Prelo3D/graber-p3d/Fotos do projeto/20.PNG

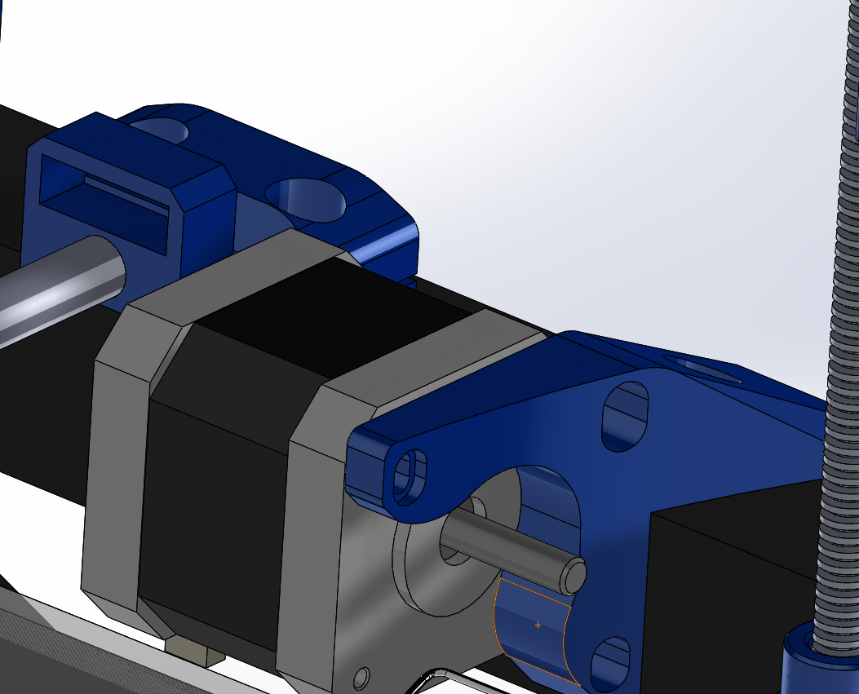
Fotos do projeto/20.PNG
