Prelo3D/graber-p3d/Fotos do projeto/16.PNG

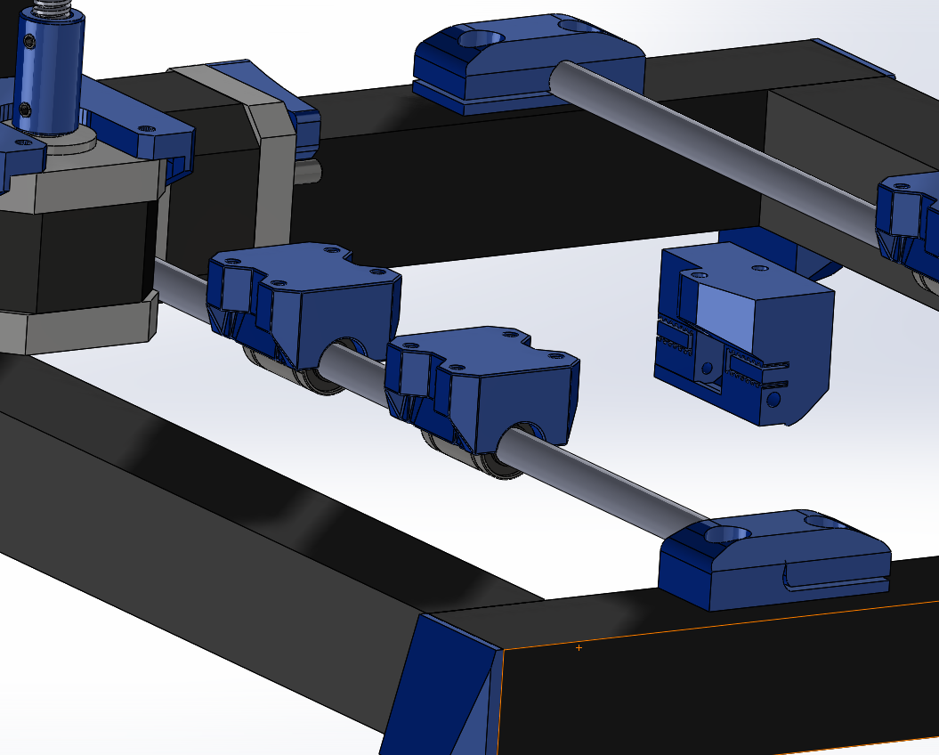
Fotos do projeto/16.PNG
