Prelo3D/graber-p3d/README.md

# **Graber-p3d**
Aqui você encontra o projeto da impressora graber-p3d com área de impressão de 220x220x220.
O projeto já está pronto, mas ainda falta terminar o upload de alguns arquivos aqui. Nosso foco é a mecânica da máquina, então, além de encontrar as fotos, STLs, arquivos em solidworks, você encontra as medidas dos perfis e guias. Você pode montar o frame em casa, e baixar nossos STLs de forma totalmente gratuita.

Significado do nome graber-p3d: Graber porque é derivada de modelos graber, e p3d por ser criado por nossa empresa, "prélo 3d".

O projeto graber-p3d foi desenvolvido para ter uma relação custo-benefício melhor em relação a outras impressoras do mercado que são feitas de perfis de alumínio, já que nosso projeto utiliza perfis de metalon.

**Qualidades/diferenças entre outros modelos graber disponíveis hoje:** 
  <br />   *Permite colocar mesa aquecida de até 240x240mm e ter uma área de impressão de 220x220x220mm. 
  <br />   *É possível comprar o tubo de metalon, e montar em casa por um ótimo custo-benefício. 
  <br />   *Mais resistênte que perfis de alumínio: O metalon por ser todo soldado, não gera folga com o tempo, ao contrário dos perfis de alumínio que devem ser reapertados com o passar do tempo. 
  <br />   *Sistema bowdem, permitindo uma maior velocidade de impressão (projeto para extrusora direct está em desenvolvimento).

**Medidas externas do frame montado:**
<br />X: 325mm 
<br />Y: 385mm 
<br />Z: 355mm

**Medidas e quantidades de perfis necessários para a montagem:**
<br /> 2 perfis para X base: 325mm (perfil frontal e traserio onde vai preso os suportes das guias das mesas) 
<br /> 1 perfil para X topo: 265mm (onde vai preso a extrusora encima) 
<br /> 2 perfis para Y: 325mm 
<br /> 2 perfis para Z: 325mm

Como podemos ver, temos 6 perfis com as medidas de 325mm e somente um perfil com medida diferente de 265mm, isso facilita o corte e montagem.

**Medidas das guias:**
Medidas necessárias das guias (as peças impressas tem furação para encaixe da guia, e tem um tamanho mínimo e máximo recomendável, qualquer medida dentro dessa variação de tamanho pode ser usada sem problemas:

<br /> X: 330 a 355mm 
<br /> Y: 320 a 340mm 
<br /> Z: 300 a 303mm (pode ser usada maior, mas vai sobrar para fora da peça impressa em cima).

**Dúvidas:**
<br /> Posso migrar da graber para esse projeto? Esse projeto é baseado na graber original, então impressoras derivadas da graber, como por exemplo a agraber, pode ser reaproveitado peças impressas para montagem nesse frame. Porém como esse projeto é diferente da agraber, algumas peças impressas da agraber não encaixem: Os suportes dos pés, o suporte dos motores do z, z topo e o suporte para a placa.

**Suporte para placa e painel:** 
<br /> Por padrão, esse projeto está finalizado com suporte para placa skr 1.4 turbo e painel 12864, se quiser suporte para outros modelos de placas, favor solicitar o stl ou as peças impressas (no caso da compra das peças impressas) que projetamos para a placa que precisar.

**Suporte extrusora:**
<br />  O suporte atual foi projetado para hotend v6 e sensor bltouch. O resfriamento da peça que está sendo impressa é feita através de um cooler 40x40 (nas fotos tem o modelo).

Para compra do frame e/ou peças impressas acesse: https://www.prelo3d.com.br/
