Prelo3D/graber-p3d/Informações.md

# graber-p3d

  Projeto impressora graber 220x220x220

Significado do nome: Graber porque é derivada de modelos graber, e p3d por ser criado por nossa empresa, "prélo 3d". 

O projeto graber-p3d foi desenvolvido para ter uma relação custo/benefício melhor em relação a outras impressoras do mercado, como a agraber (https://github.com/acguardia/AGraber-30i) por exemplo que é feita de perfis de alumínio, já que nosso modelo utiliza perfis de metalon. 

Algumas qualidades/diferenças entre outros modelos graber disponíveis hoje:
*Permite colocar mesa aquecida de até 240x240mm e ter uma área de impressão de 220x220x220mm. 
*É possível comprar o tubo de metalon, e montar em casa por um ótimo custo/benefício.
*Mais resistênte que perfis de alumínio: O metalon por ser todo soldado, não gera folga com o tempo, ao contrário dos perfis de alumínio que devem ser reapertados com o passar do tempo.
*Sistema bowdem, permitindo uma maior velocidade de impressão.

Medidas externas do frame montado:
X: 325mm
Y: 385mm
Z: 355mm

Medidas e quantidades de perfis necessários para a montagem:
2 perfis para X base: 325mm (perfil frontal e trazerio onde vai preso os suportes das guias das mesas)
1 perfil para X topo: 265mm (onde vai preso a extrusora encima) 
2 perfis para Y: 325mm
2 perfis para Z: 325mm

Como podemos ver, temos 6 perfis com as medidas de 325mm e somente um perfil com medida diferente de 265mm, isso permite o corte e montagem. 

  # Medidas das guias:

Medidas necessárias das guias (as peças impressas tem furação para encaixe da guia, e tem um tamanho mínimo e máximo recomendável, qualquer medida dentro dessa variação de tamanho pode ser usada sem problemas:

X: 330 a 355mm
Y: 320 a 340mm
Z: 300 a 303mm (pode ser usada maior, mas vai sobrar para fora da peça impressa encima).

  # Dúvidas
  Posso migrar da graber para esse projeto? 
Esse projeto é baseado na graber original, então impressoras derivadas da graber, como por exemplo a agraber, pode ser reaproveitado peças impressas para montagem nesse frame. Porém como esse projeto é diferente da agraber, algumas peças impressas da agraber não encaixem: Os suportes dos pés, o suporte dos motores do z, z topo e o suporte para a placa.

  Suporte para placa e painel: Por padrão, esse projeto está finalizado com suporte para placa skr 1.4 turbo e painel 12864, se quiser suporte para outros modelos de placas, favor solicitar o stl ou as peças impressas (no caso da compra das peças imnpressas) que projetamos para a placa que precisar.

Suporte extrusora: O suporte atual foi projetado para hotend v6 e sensor bltouch. O resfriamento da peça que está sendo impressa é feita através de um cooler 40x40 (nas fotos tem o modelo).

Para compra do frame e/ou peças impressas acesse: https://www.prelo3d.com.br/
