Prelo3D/graber-p3d/Fotos do projeto/01.PNG

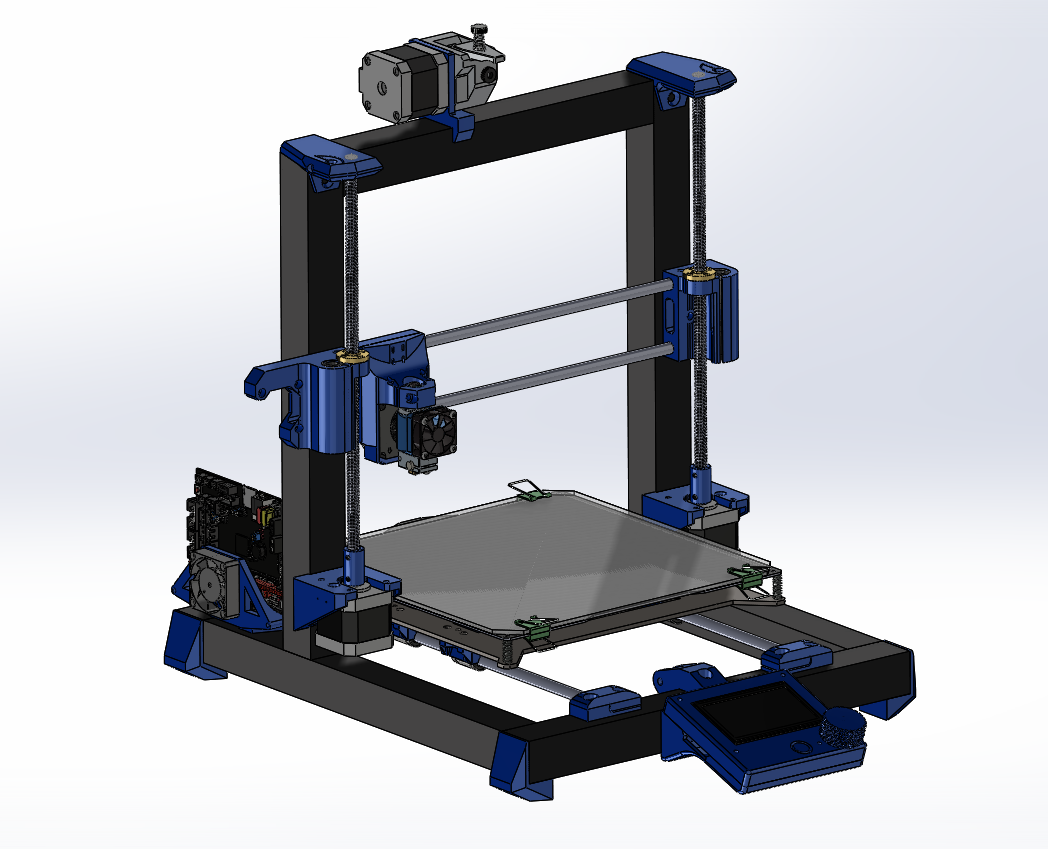
Fotos do projeto/01.PNG
