Prelo3D/graber-p3d/Fotos do projeto/02.PNG

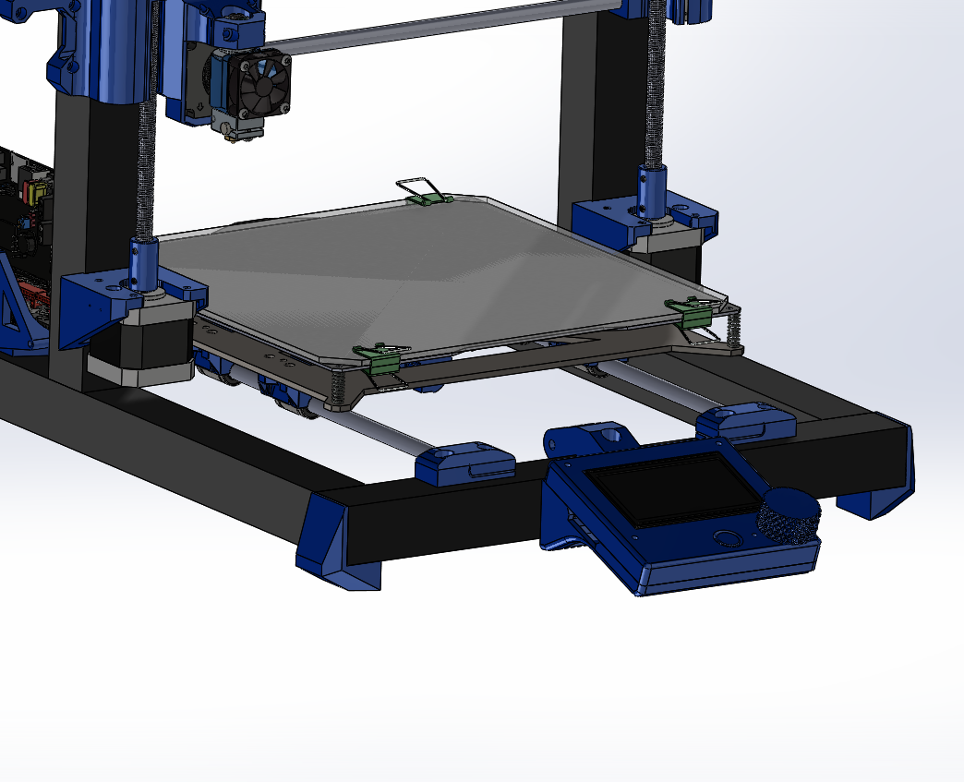
Fotos do projeto/02.PNG
