Prelo3D/graber-p3d/Fotos do projeto/03.PNG

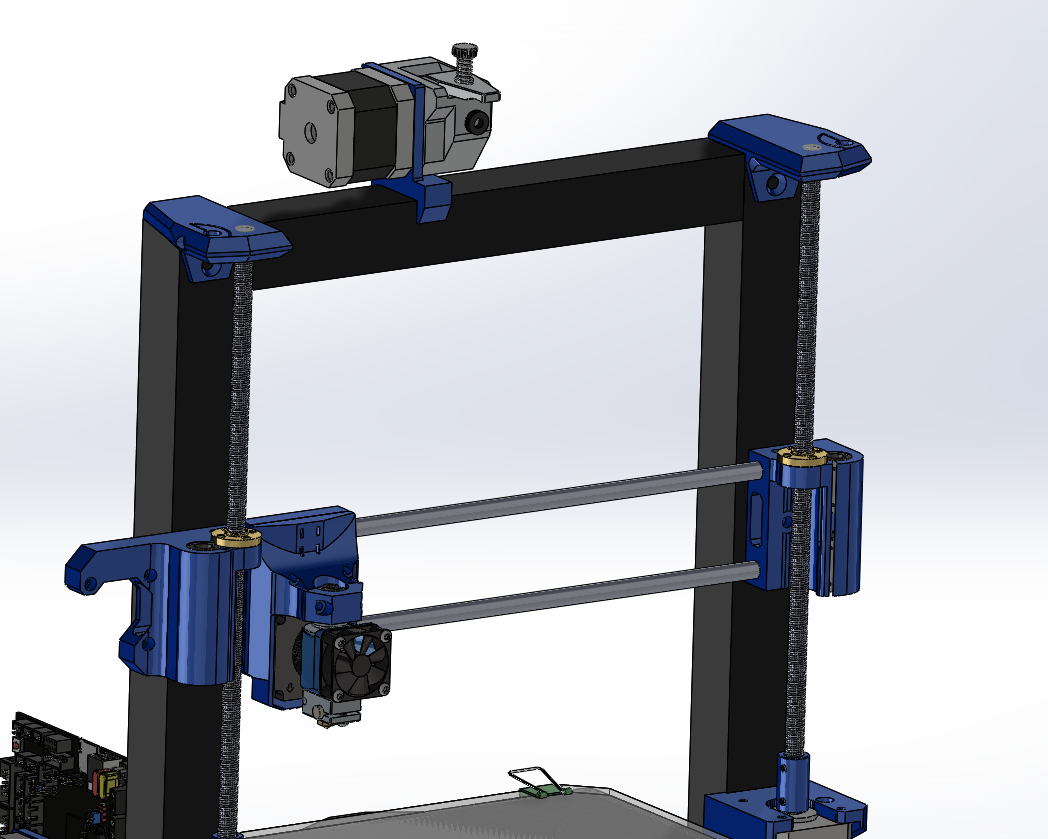
Fotos do projeto/03.PNG
