Prelo3D/graber-p3d/Fotos do projeto/04.PNG

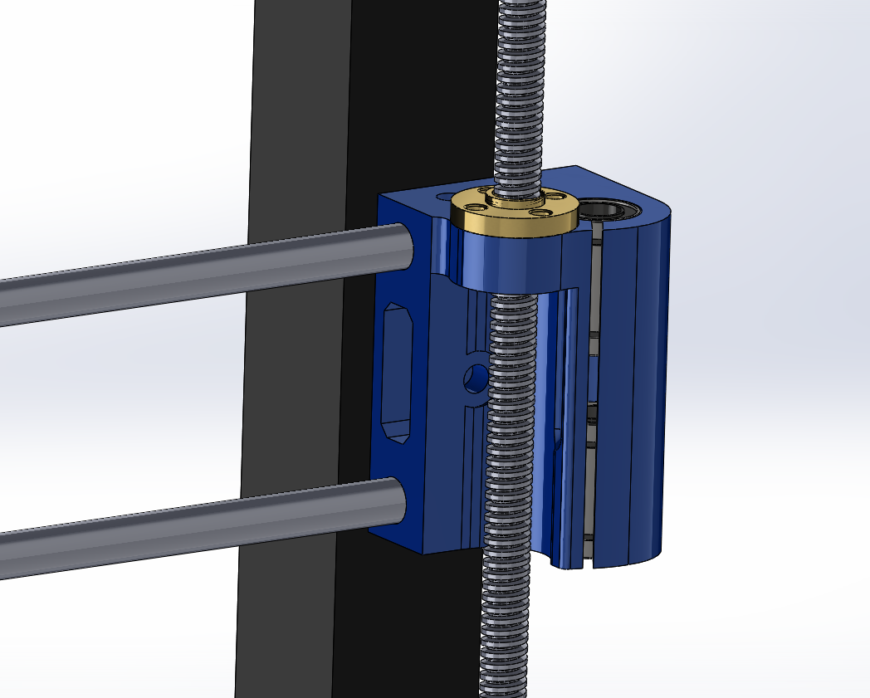
Fotos do projeto/04.PNG
