Prelo3D/graber-p3d/Fotos do projeto/05.PNG

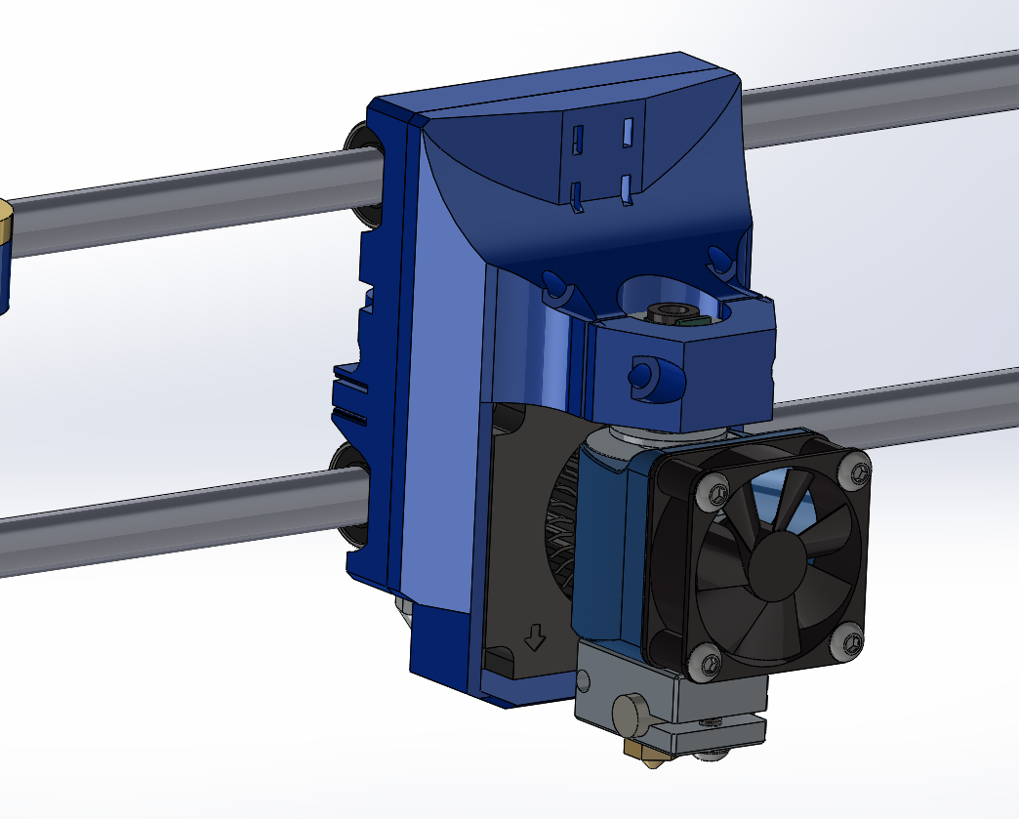
Fotos do projeto/05.PNG
