Prelo3D/graber-p3d/Fotos do projeto/06.PNG

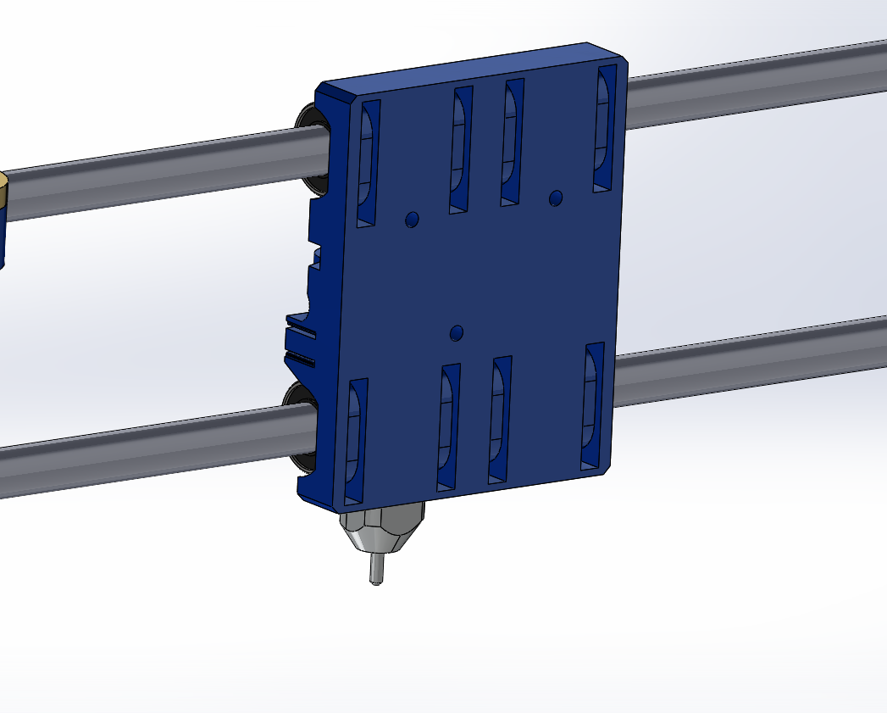
Fotos do projeto/06.PNG
