Prelo3D/graber-p3d/Fotos do projeto/07.PNG

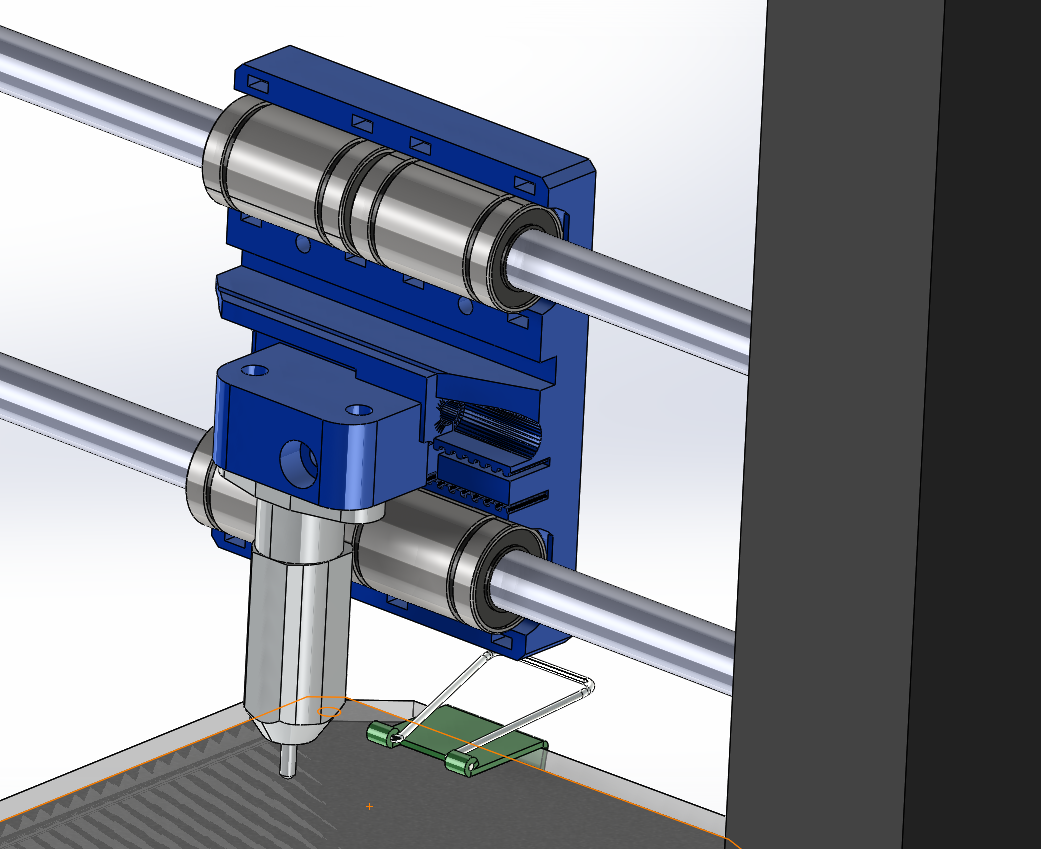
Fotos do projeto/07.PNG
