Prelo3D/graber-p3d/Fotos do projeto/08.PNG

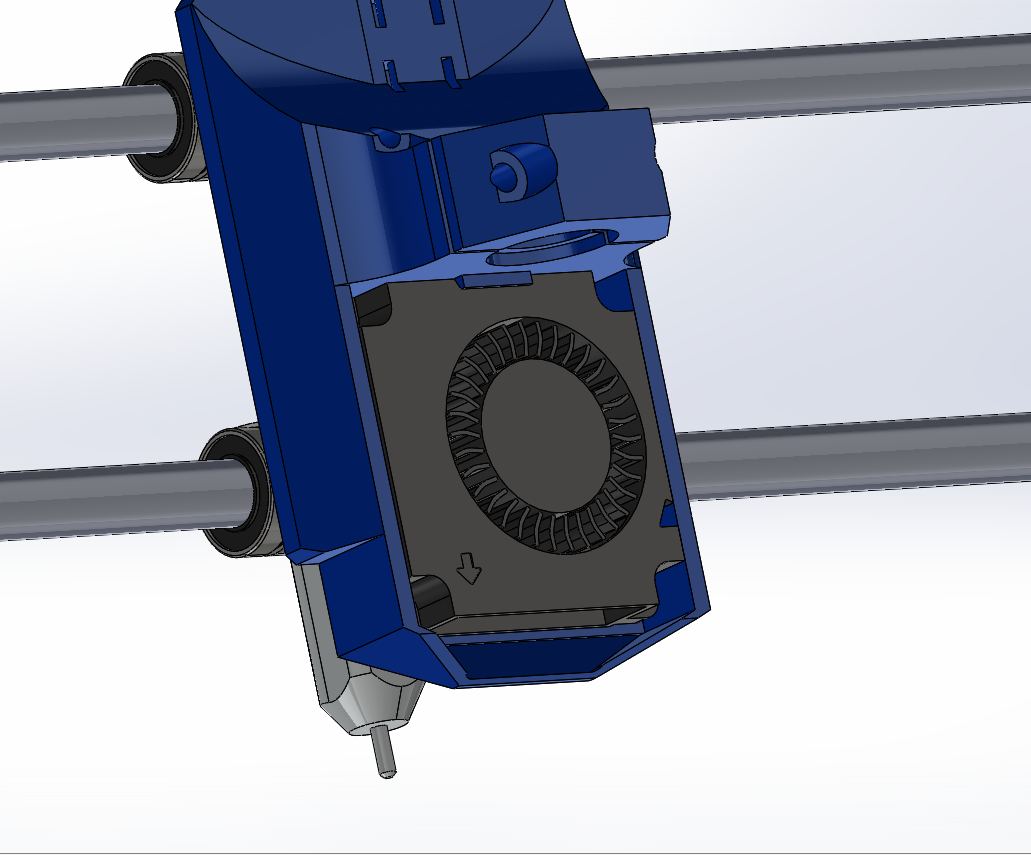
Fotos do projeto/08.PNG
