Prelo3D/graber-p3d/Fotos do projeto/09.PNG

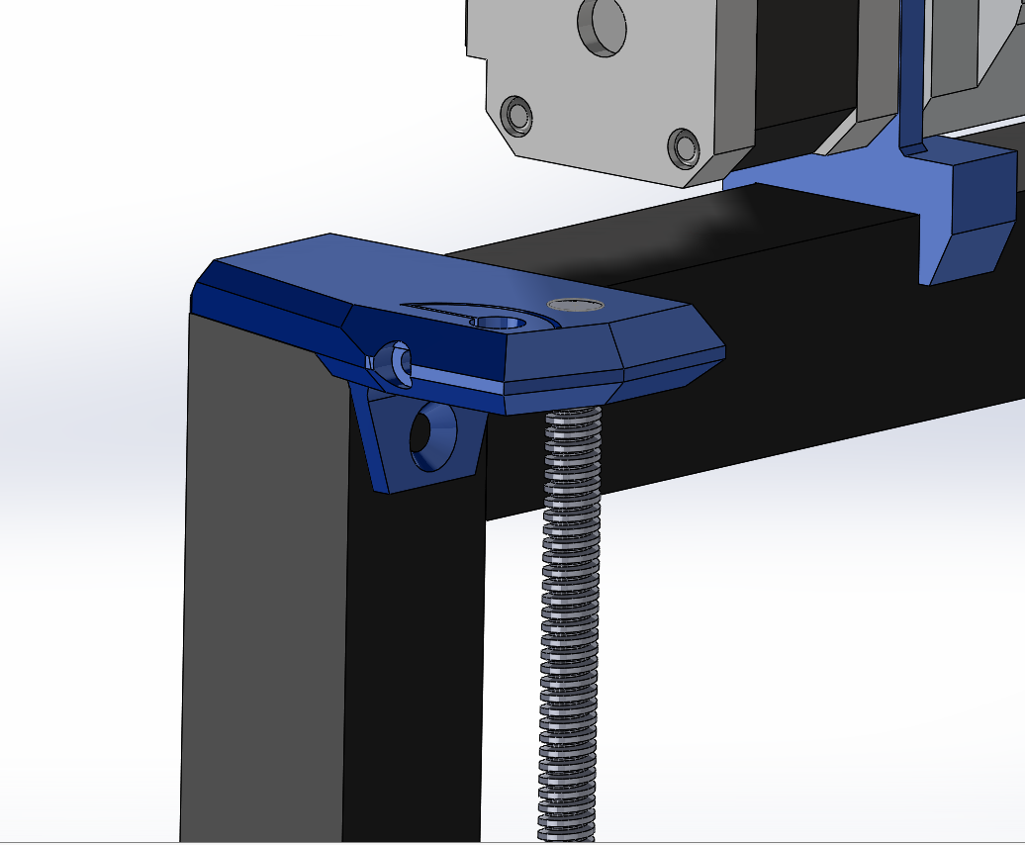
Fotos do projeto/09.PNG
