Prelo3D/graber-p3d/Fotos do projeto/10.PNG

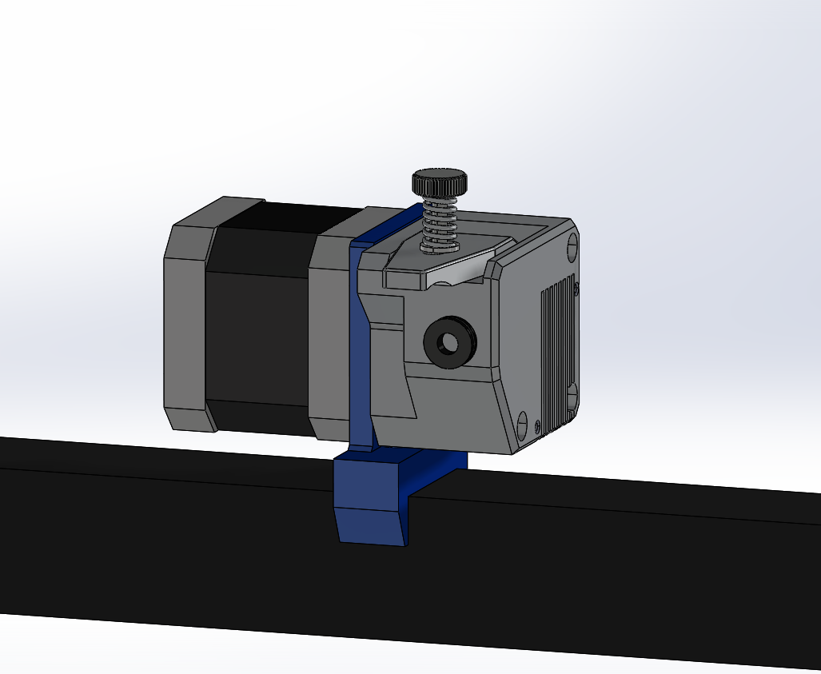
Fotos do projeto/10.PNG
