Prelo3D/graber-p3d/Fotos do projeto/11.PNG

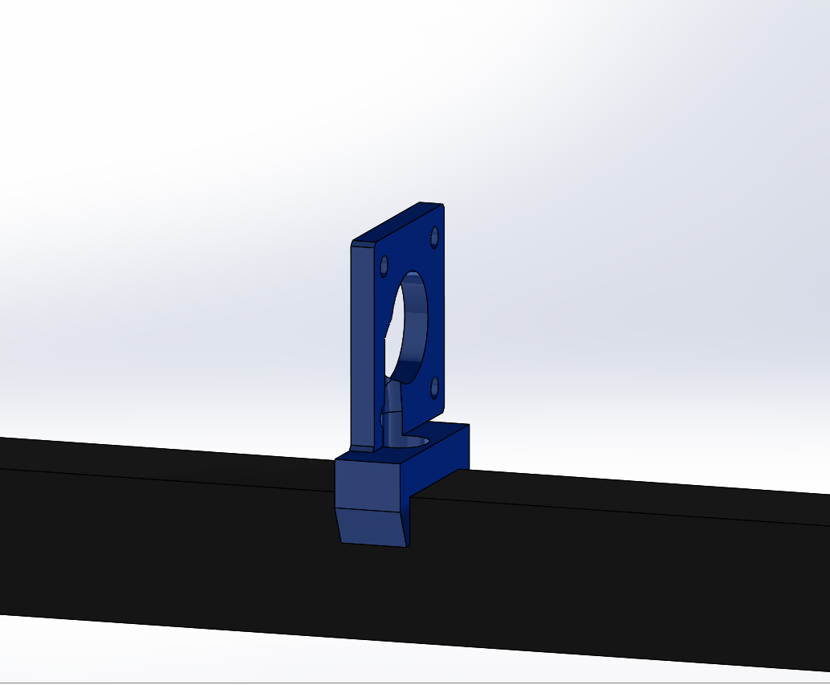
Fotos do projeto/11.PNG
