Prelo3D/graber-p3d/Fotos do projeto/12.PNG

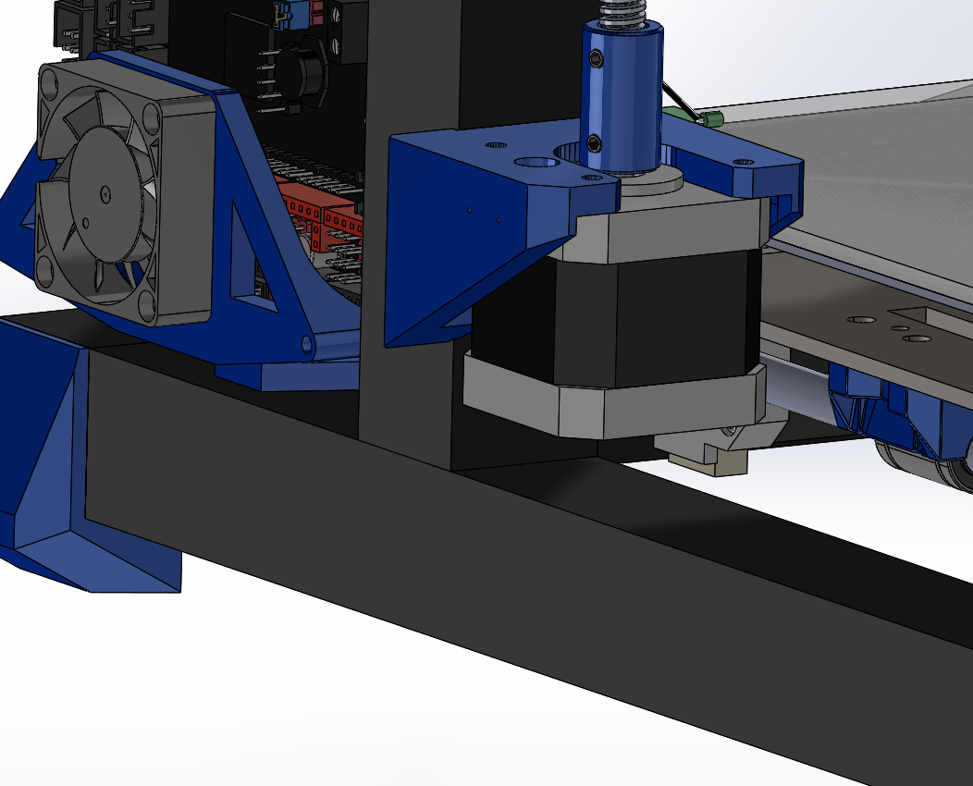
Fotos do projeto/12.PNG
