Prelo3D/graber-p3d/Fotos do projeto/13.PNG

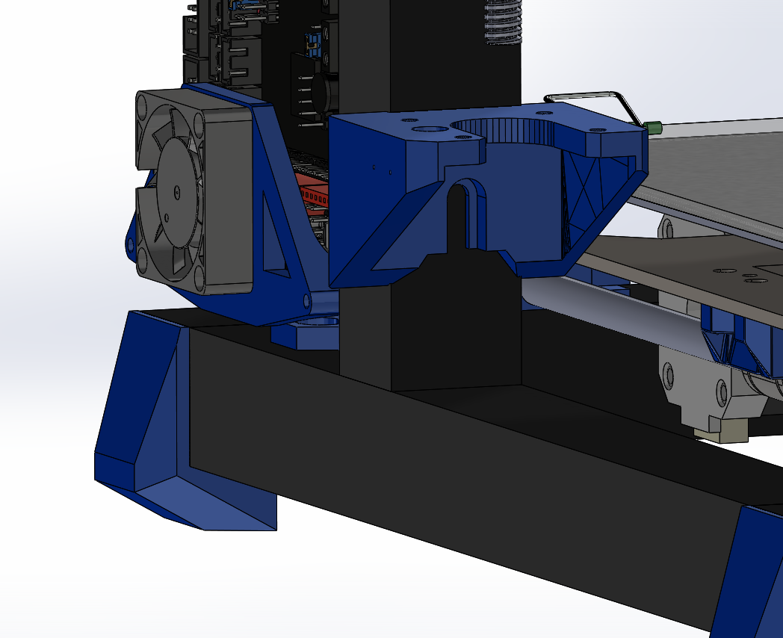
Fotos do projeto/13.PNG
