Prelo3D/graber-p3d/Fotos do projeto/14.PNG

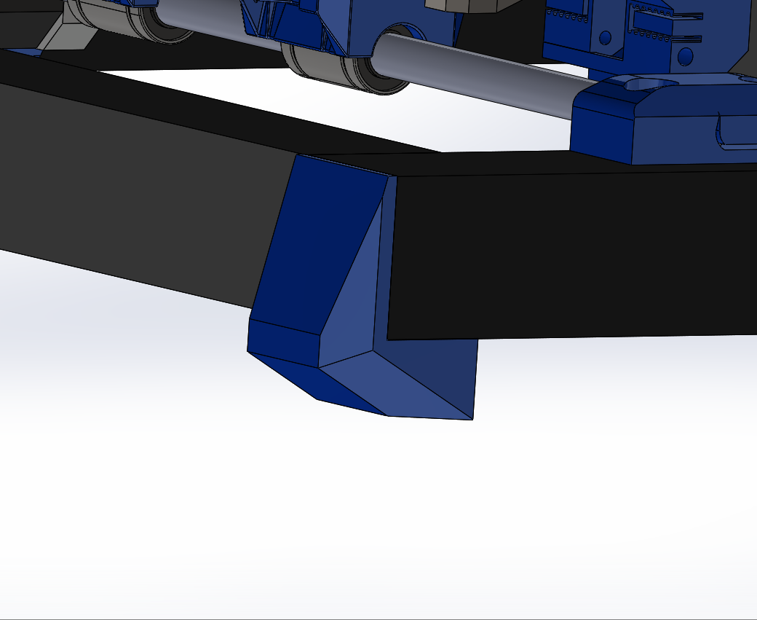
Fotos do projeto/14.PNG
