Prelo3D/graber-p3d/Fotos do projeto/15.PNG

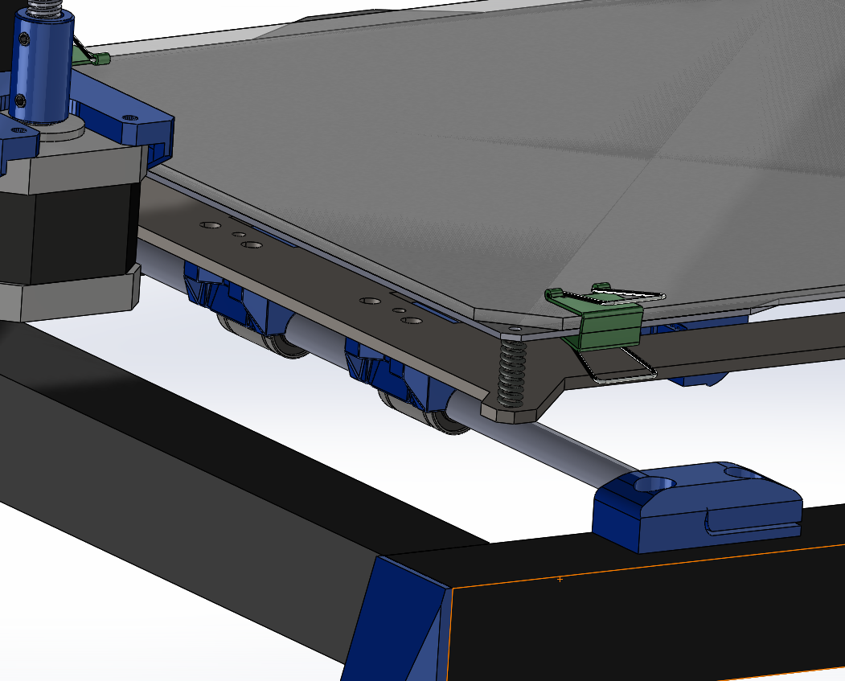
Fotos do projeto/15.PNG
