Prelo3D/graber-p3d/Fotos do projeto/17.PNG

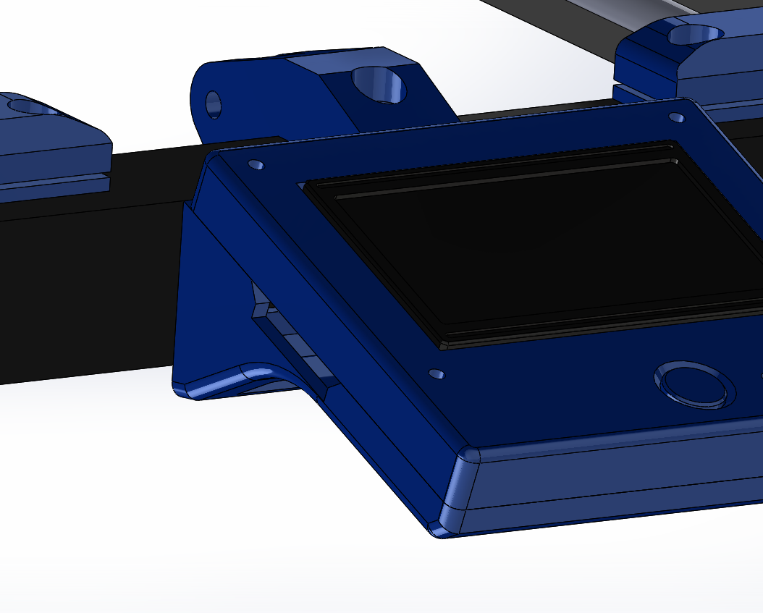
Fotos do projeto/17.PNG
