Prelo3D/graber-p3d/Fotos do projeto/18.PNG

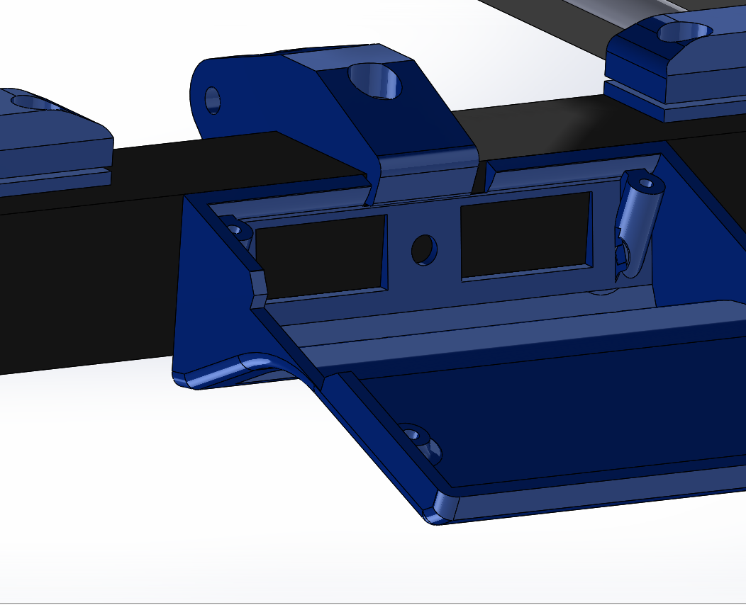
Fotos do projeto/18.PNG
