Prelo3D/graber-p3d/Fotos do projeto/19.PNG

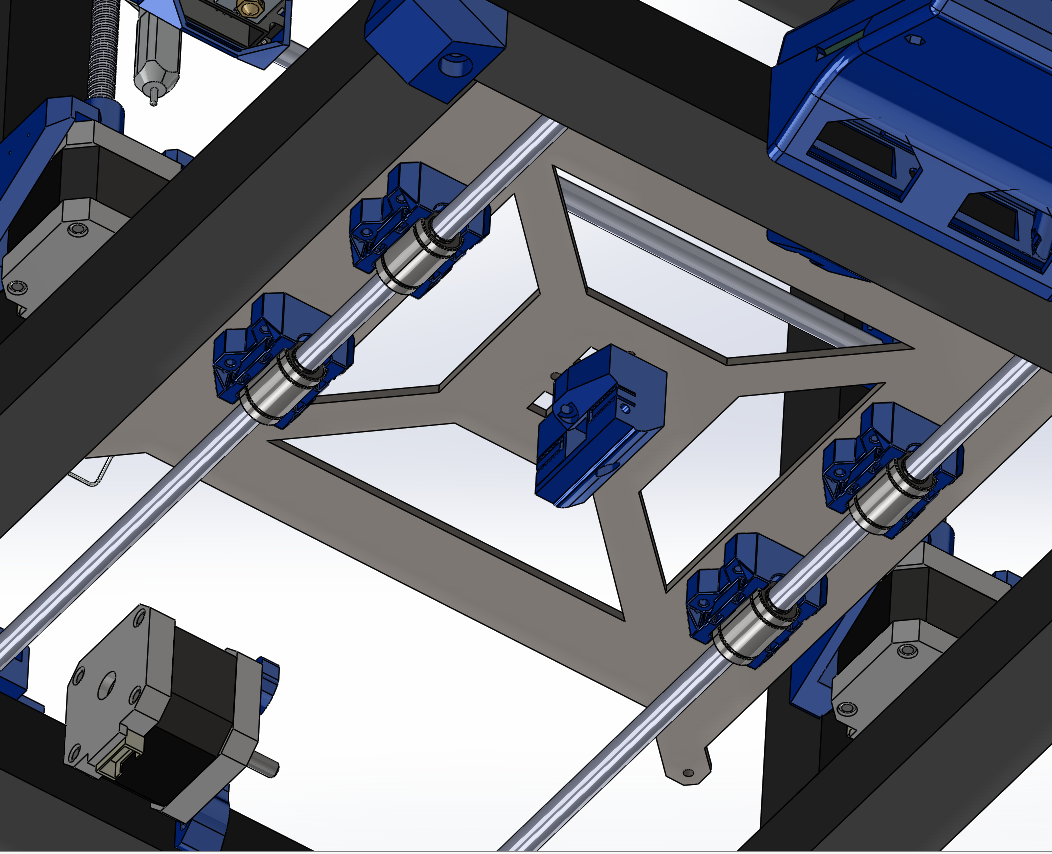
Fotos do projeto/19.PNG
