Prelo3D/graber-p3d/Fotos do projeto/21.PNG

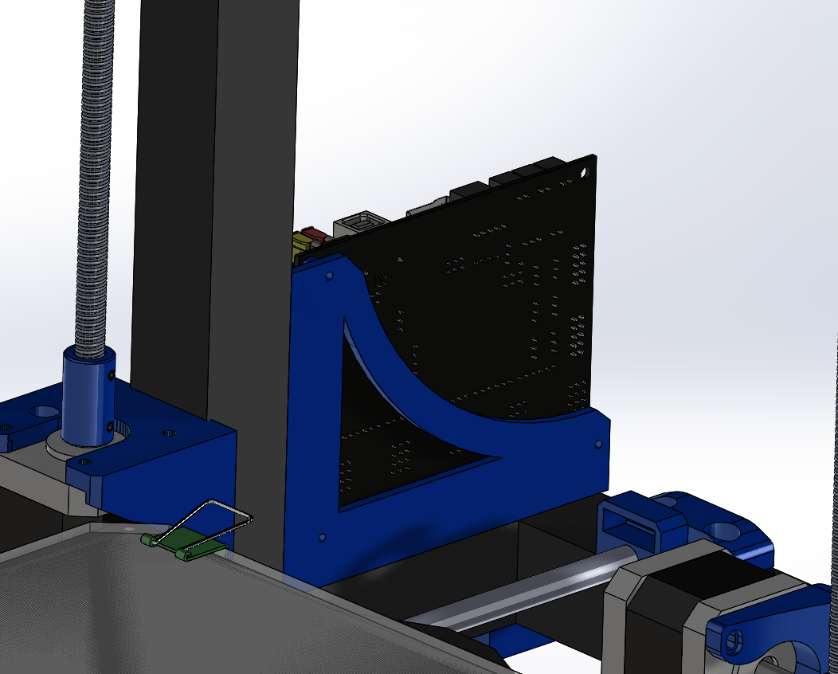
Fotos do projeto/21.PNG
