Prelo3D/graber-p3d/Fotos do projeto/22.PNG

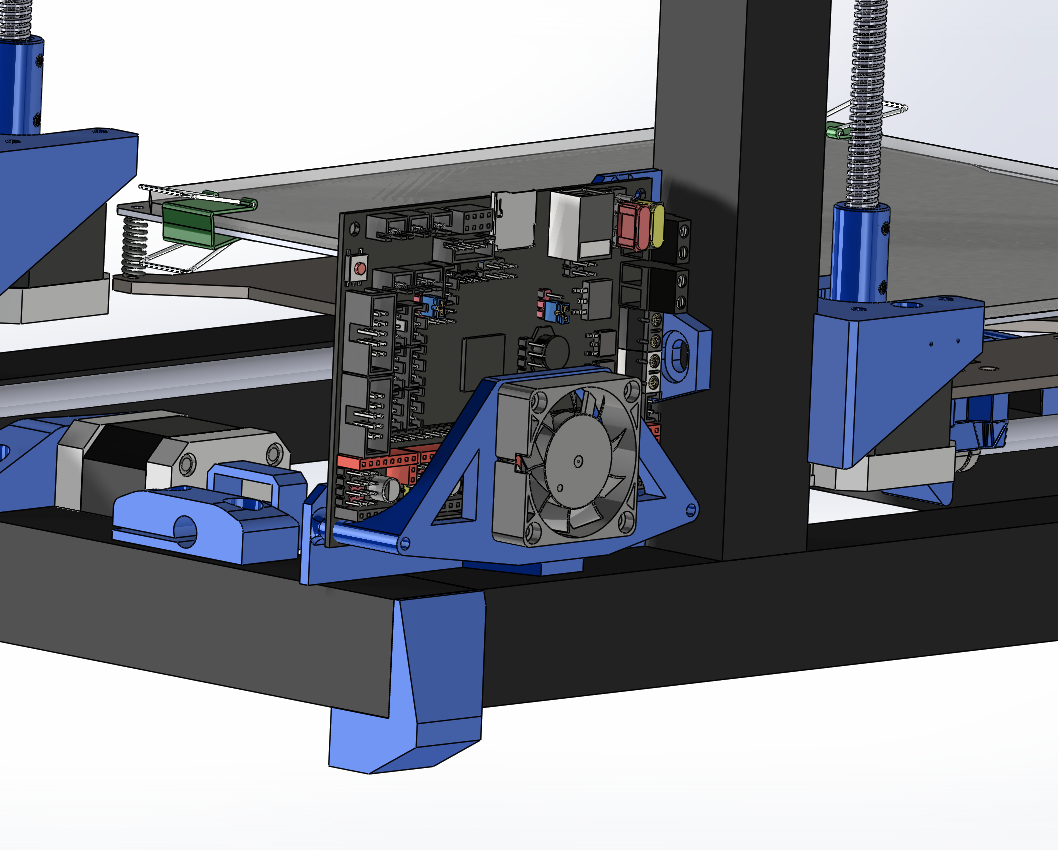
Fotos do projeto/22.PNG
