Prelo3D/graber-p3d/Fotos do projeto/23.PNG

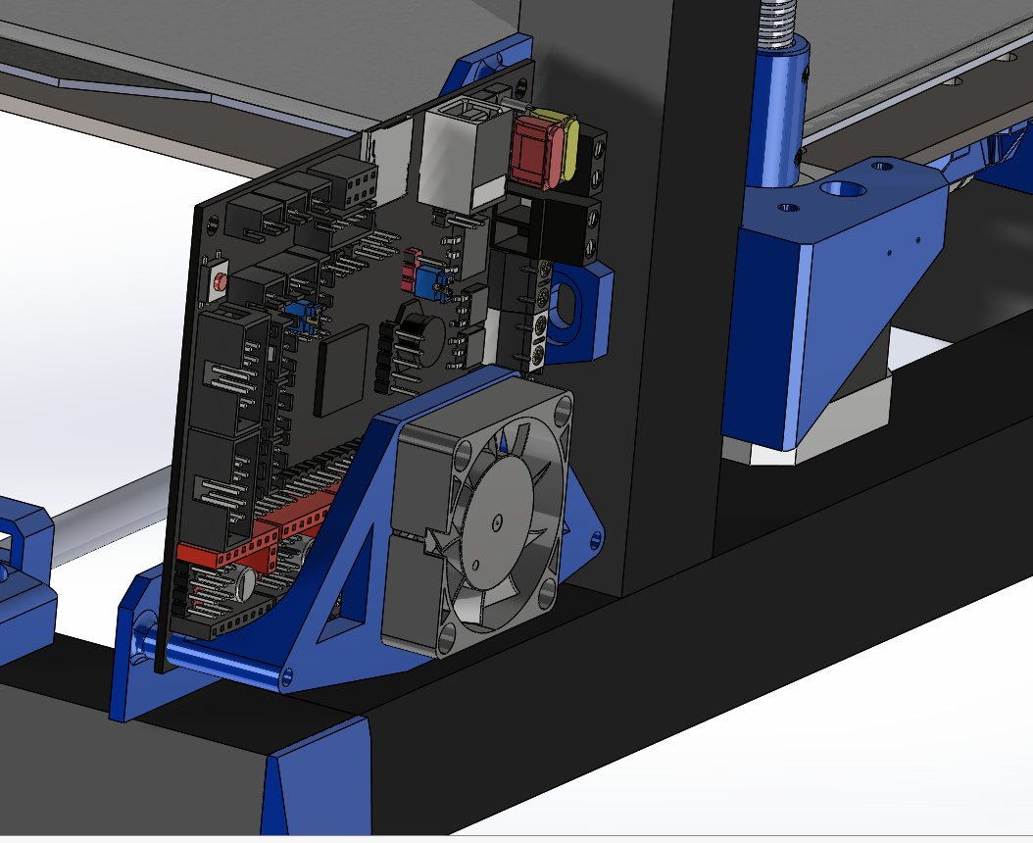
Fotos do projeto/23.PNG
