Prelo3D/graber-p3d/Fotos do projeto/24.PNG

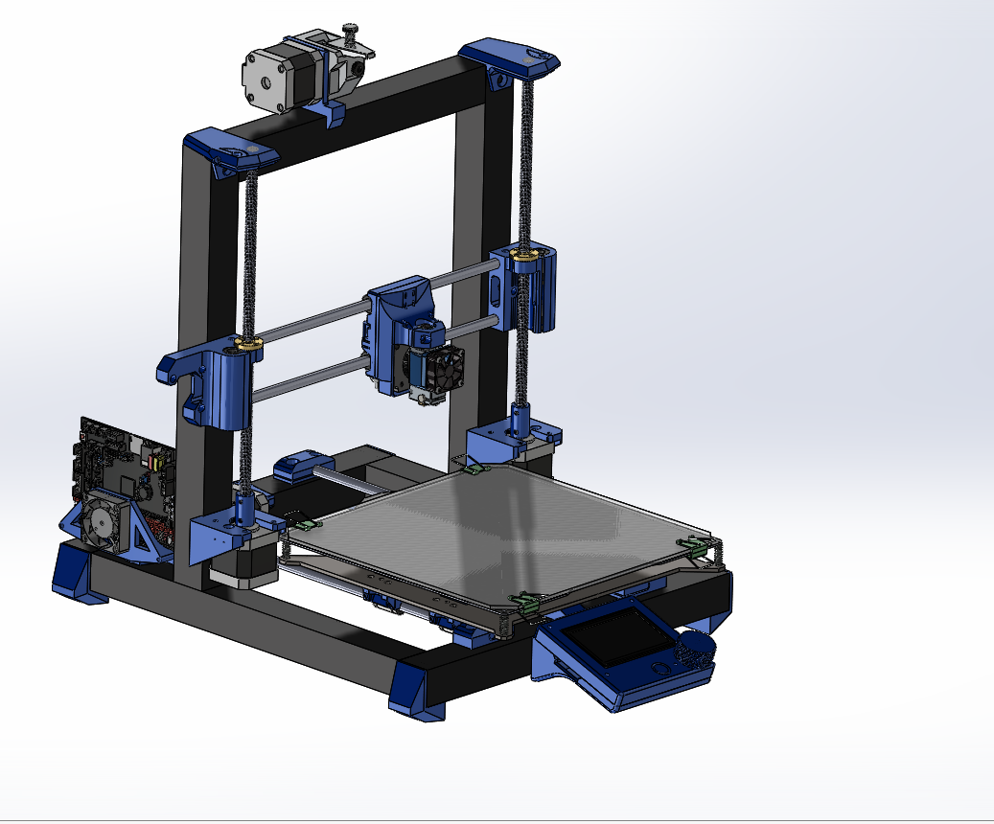
Fotos do projeto/24.PNG
