Prelo3D/graber-p3d/Fotos do projeto/25.PNG

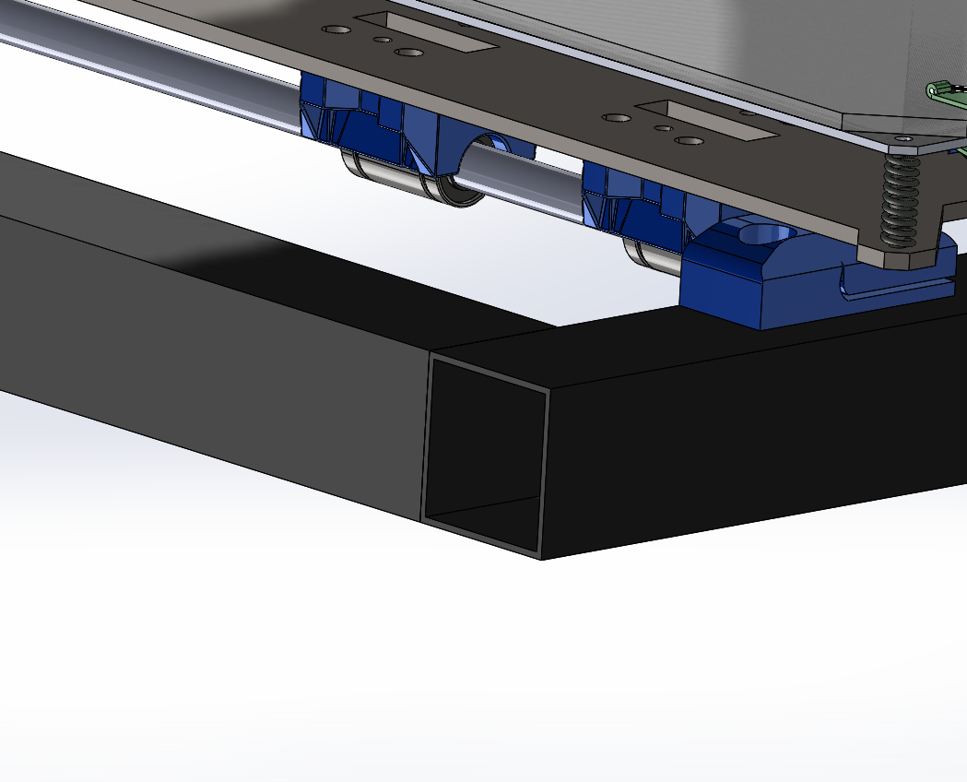
Fotos do projeto/25.PNG
