Prelo3D/graber-p3d/Fotos do projeto/26.PNG

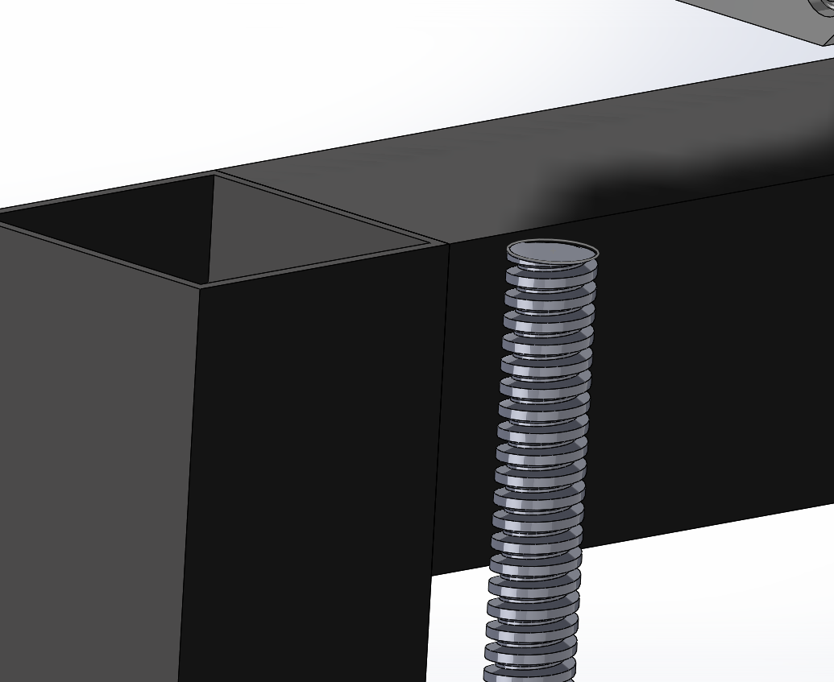
Fotos do projeto/26.PNG
