Prelo3D/graber-p3d/Baixe aqui os STLs/Eixo X/Suporte extrusora bowden.stl

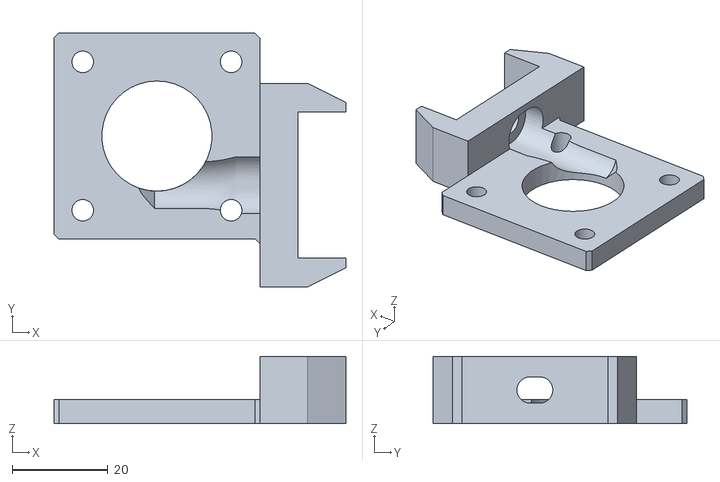
[picture p27: CAD file, 2021-09-24]
Baixe aqui os STLs/Eixo X/Suporte extrusora bowden.stl
61.0 x 53.0 x 14.0
