Prelo3D/graber-p3d/Baixe aqui os STLs/Eixo Y/Suporte frontal esquerdo guia 8mm mesa.stl

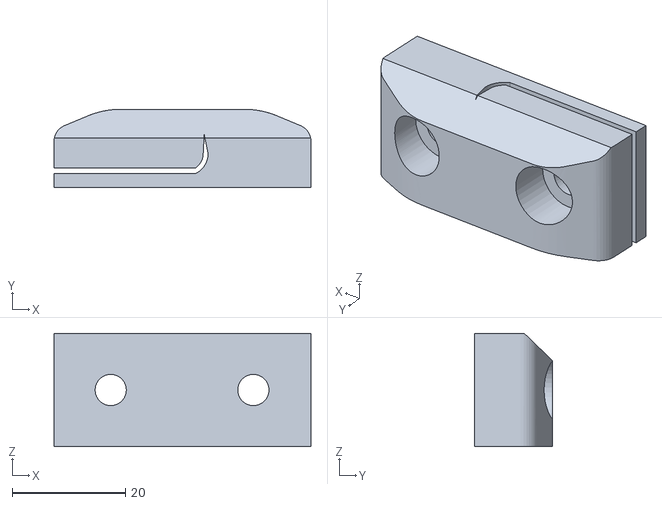
[picture p28: CAD file, 2021-09-24]
Baixe aqui os STLs/Eixo Y/Suporte frontal esquerdo guia 8mm mesa.stl
45.3 x 13.8 x 20.0
