Prelo3D/graber-p3d/Baixe aqui os STLs/Eixo Z/Suporte Z direito para rolamento 15mm.stl

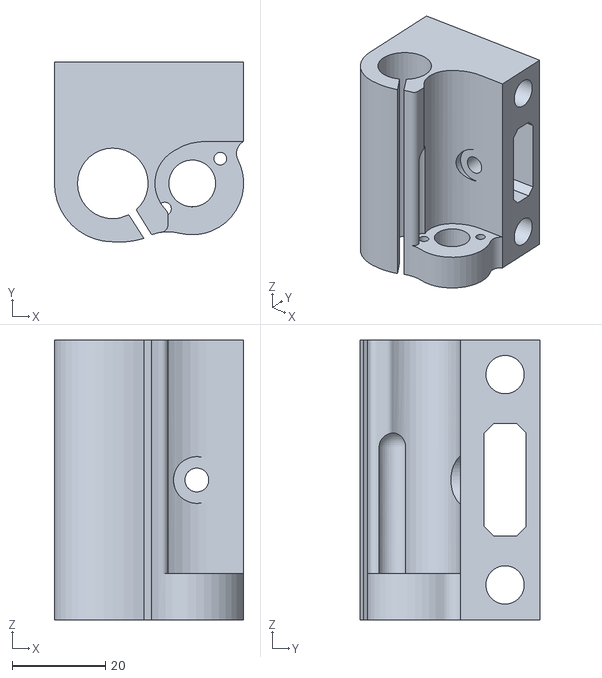
[picture p29: CAD file, 2021-09-24]
Baixe aqui os STLs/Eixo Z/Suporte Z direito para rolamento 15mm.stl
40.5 x 38.6 x 59.9
