Prelo3D/graber-p3d/Baixe aqui os STLs/Pés de apoio/Trazeiro esquerdo.stl

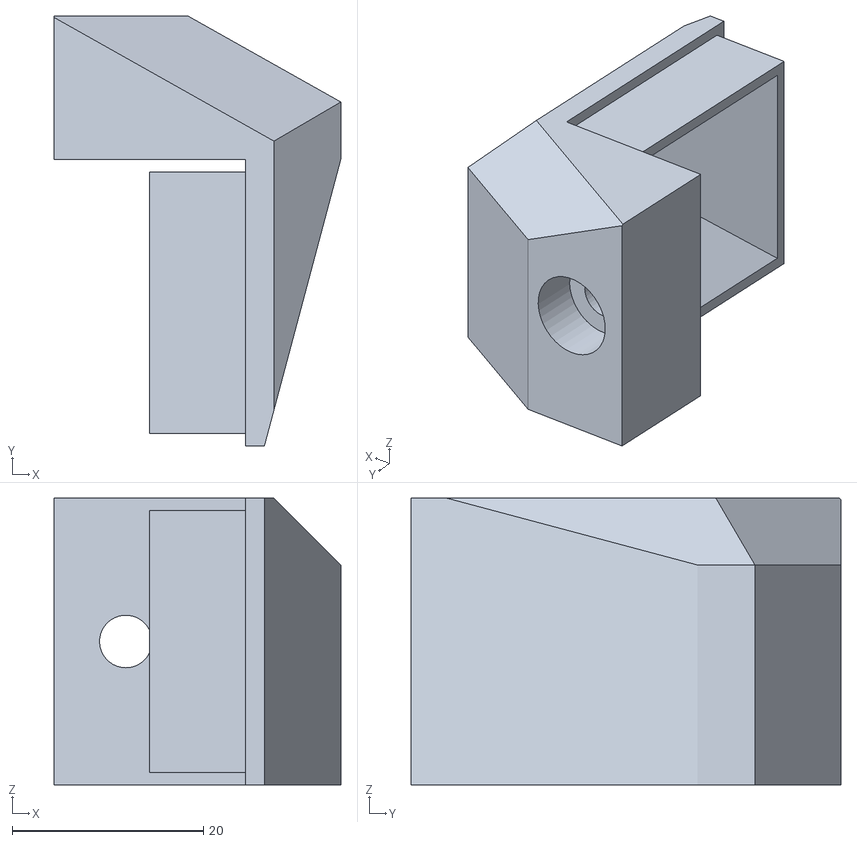
[picture p30: CAD file, 2021-09-24]
Baixe aqui os STLs/Pés de apoio/Trazeiro esquerdo.stl
30.0 x 45.0 x 30.0
