Prelo3D/graber-p3d/Baixe aqui os STLs/Suporte placas e painéis/Suporte painel 12864/Botão  painel 12864.stl

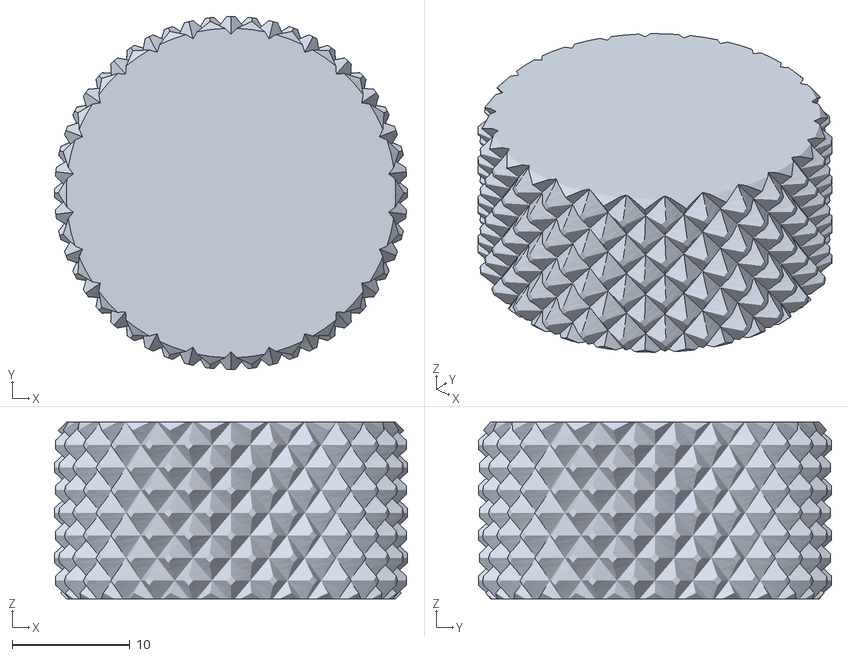
[picture p31: CAD file, 2021-09-24]
Baixe aqui os STLs/Suporte placas e painéis/Suporte painel 12864/Botão painel 12864.stl
30.0 x 30.0 x 15.0
