Prelo3D/graber-p3d/Baixe aqui os STLs/Suporte placas e painéis/Suporte panel duet 5" (painel pequeno da duet wifi)/Suporte panel due 5 polegadas (Painel da duet wifi).stl

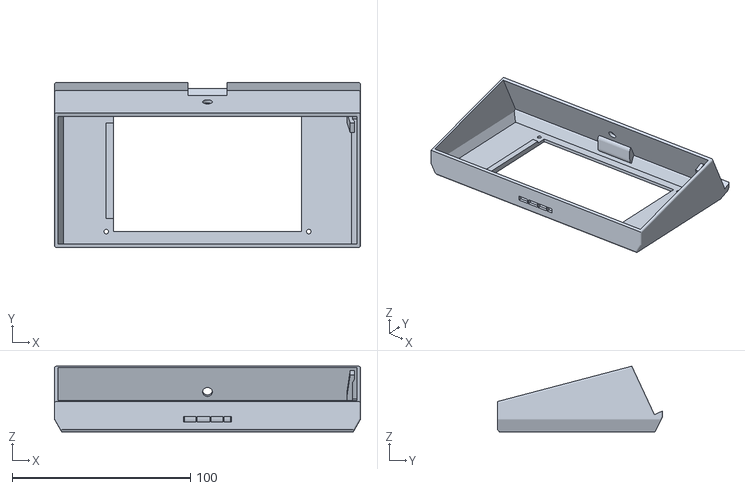
[picture p32: CAD file, 2021-10-19]
Baixe aqui os STLs/Suporte placas e painéis/Suporte panel duet 5" (painel pequeno da duet wifi)/Suporte panel due 5 polegadas (Painel da duet wifi).stl
171.5 x 92.6 x 36.8
