Prelo3D/graber-p3d/Baixe aqui os STLs/Suporte placas e painéis/Suporte placa duet wifi e3 mini/Suporte duet mini 5+ v0.5.stl

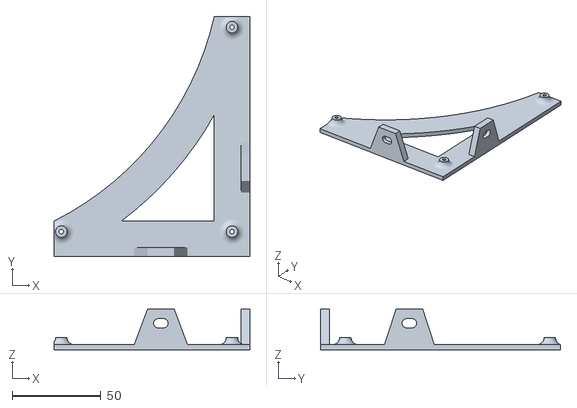
[picture p33: CAD file, 2021-10-19]
Baixe aqui os STLs/Suporte placas e painéis/Suporte placa duet wifi e3 mini/Suporte duet mini 5+ v0.5.stl
110.0 x 135.0 x 23.0
