Prelo3D/graber-p3d/Baixe aqui os STLs/Suporte placas e painéis/Suporte placa SKR 1.4 e 1.4 turbo/Suporte cooler SKR 1.4 turbo.stl

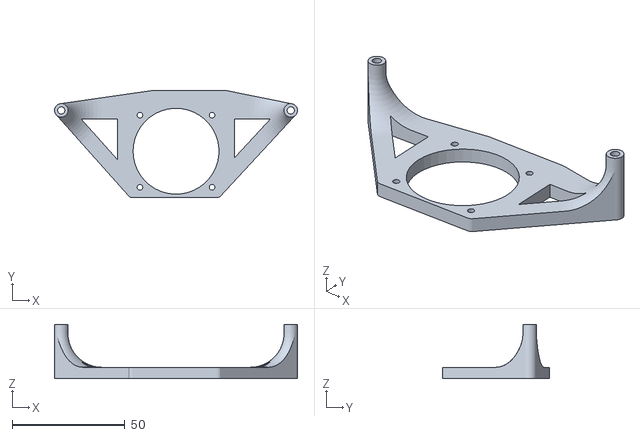
[picture p34: CAD file, 2021-09-24]
Baixe aqui os STLs/Suporte placas e painéis/Suporte placa SKR 1.4 e 1.4 turbo/Suporte cooler SKR 1.4 turbo.stl
107.8 x 47.6 x 24.0
