Prelo3D/graber-p3d/Baixe aqui os STLs/Eixo X/Suporte bowden hotend V6.stl

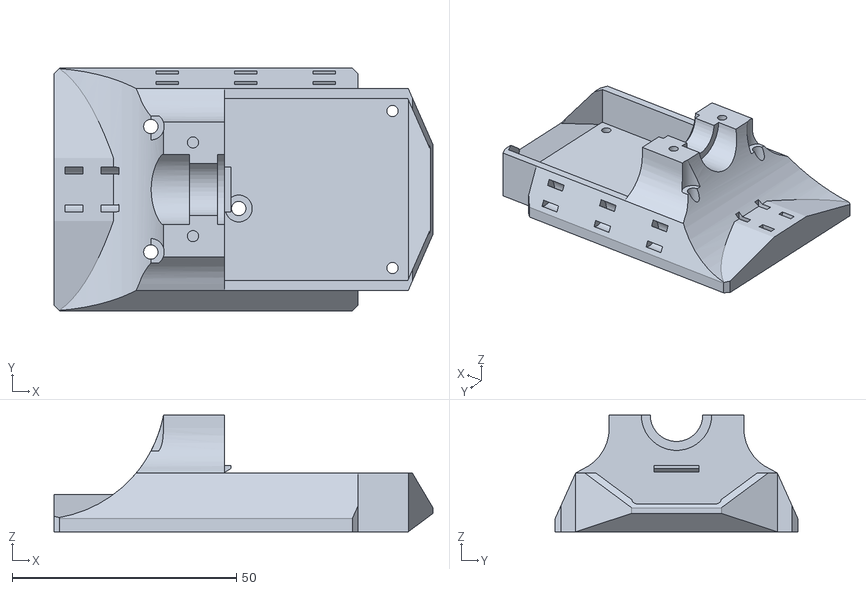
[picture p35: CAD file, 2021-09-24]
Baixe aqui os STLs/Eixo X/Suporte bowden hotend V6.stl
84.5 x 54.1 x 26.0
