Prelo3D/graber-p3d/Baixe aqui os STLs/Eixo Z/Suporte Z esquerdo para rolamento 15mm.stl

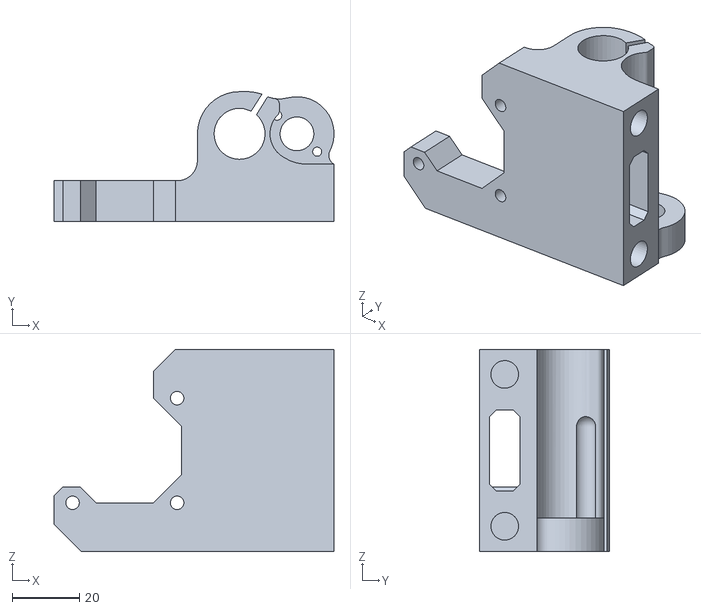
[picture p36: CAD file, 2021-09-24]
Baixe aqui os STLs/Eixo Z/Suporte Z esquerdo para rolamento 15mm.stl
83.0 x 38.6 x 59.9
