Prelo3D/graber-p3d/Baixe aqui os STLs/Suporte placas e painéis/Suporte painel 12864/Fundo painel 12864.STL

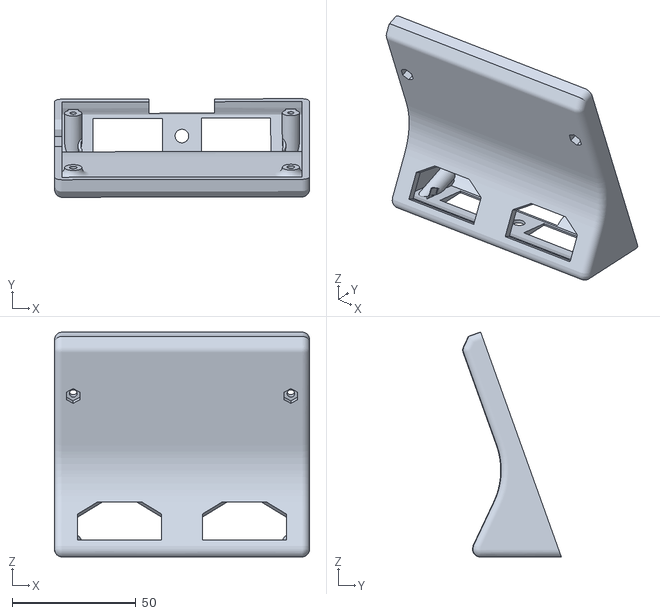
[picture p37: CAD file, 2021-09-24]
Baixe aqui os STLs/Suporte placas e painéis/Suporte painel 12864/Fundo painel 12864.STL
103.1 x 39.9 x 90.8
