Prelo3D/graber-p3d/Baixe aqui os STLs/Suporte placas e painéis/Suporte placa SKR 1.4 e 1.4 turbo/Suporte SKR 1.4 turbo.stl

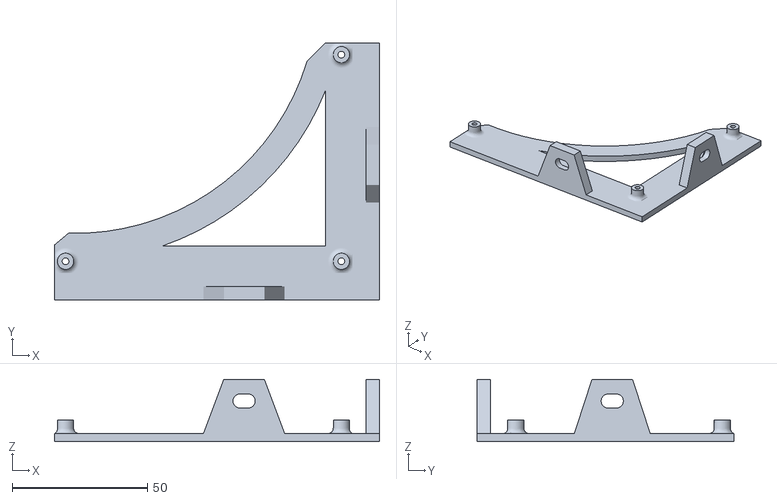
[picture p38: CAD file, 2021-09-24]
Baixe aqui os STLs/Suporte placas e painéis/Suporte placa SKR 1.4 e 1.4 turbo/Suporte SKR 1.4 turbo.stl
120.0 x 95.0 x 23.0
