Prelo3D/graber-p3d/Baixe aqui os STLs/Eixo X/Esticador correia X.stl

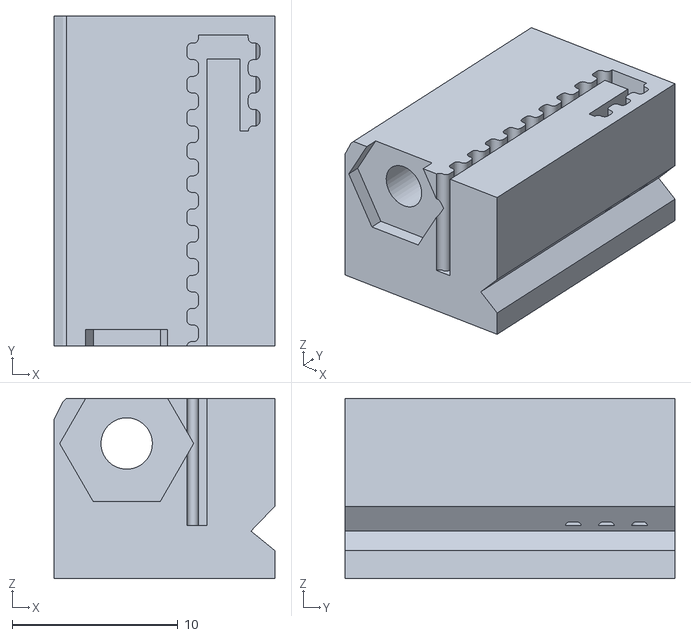
[picture p39: CAD file, 2021-09-24]
Baixe aqui os STLs/Eixo X/Esticador correia X.stl
13.3 x 19.9 x 10.9
