Prelo3D/graber-p3d/Baixe aqui os STLs/Eixo Z/Suporte motor Z esquerdo.stl

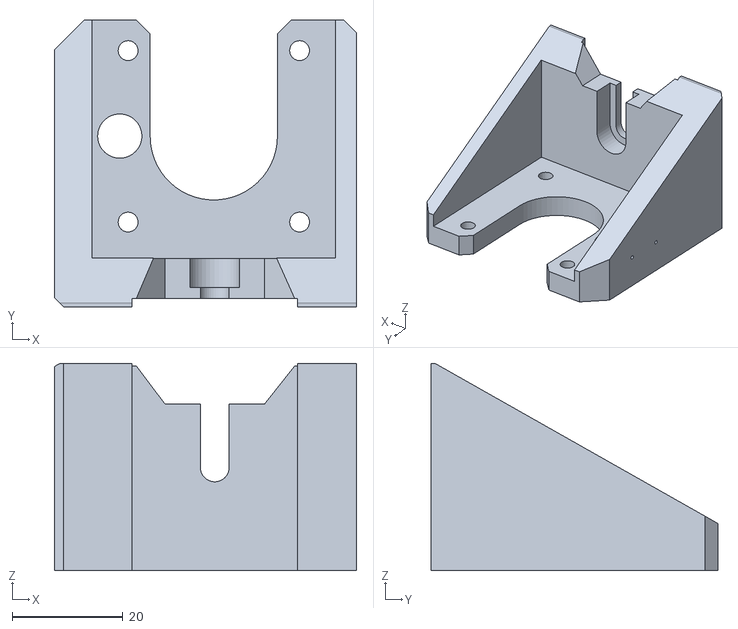
[picture p40: CAD file, 2021-09-24]
Baixe aqui os STLs/Eixo Z/Suporte motor Z esquerdo.stl
54.6 x 51.8 x 37.5
