Prelo3D/graber-p3d/Baixe aqui os STLs/Suporte placas e painéis/Suporte painel 12864/Tampa painel 12864.STL

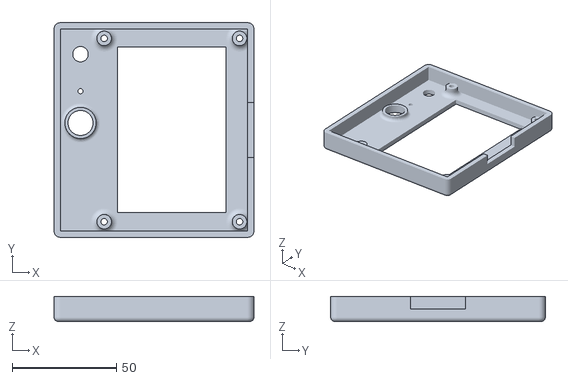
[picture p41: CAD file, 2021-09-24]
Baixe aqui os STLs/Suporte placas e painéis/Suporte painel 12864/Tampa painel 12864.STL
96.0 x 103.0 x 12.0
