Prelo3D/graber-p3d/Baixe aqui os STLs/Eixo X/Suporte bltouch.stl

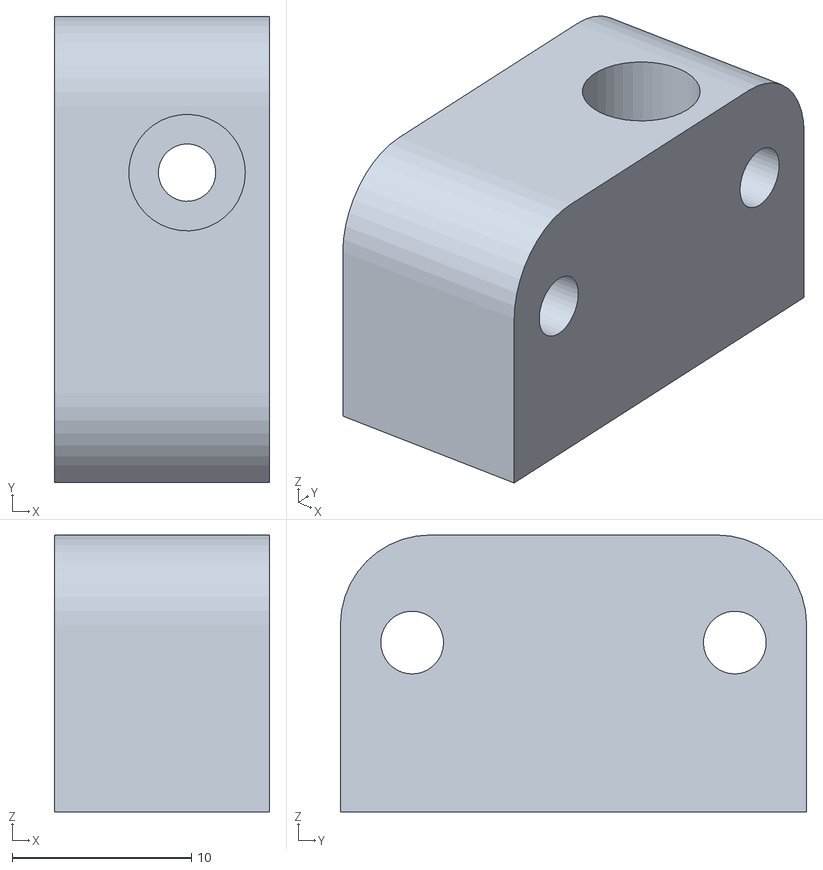
[picture p42: CAD file, 2021-09-24]
Baixe aqui os STLs/Eixo X/Suporte bltouch.stl
12.0 x 26.0 x 15.5
