Prelo3D/graber-p3d/Baixe aqui os STLs/Eixo X/Presilha hotend V6.stl

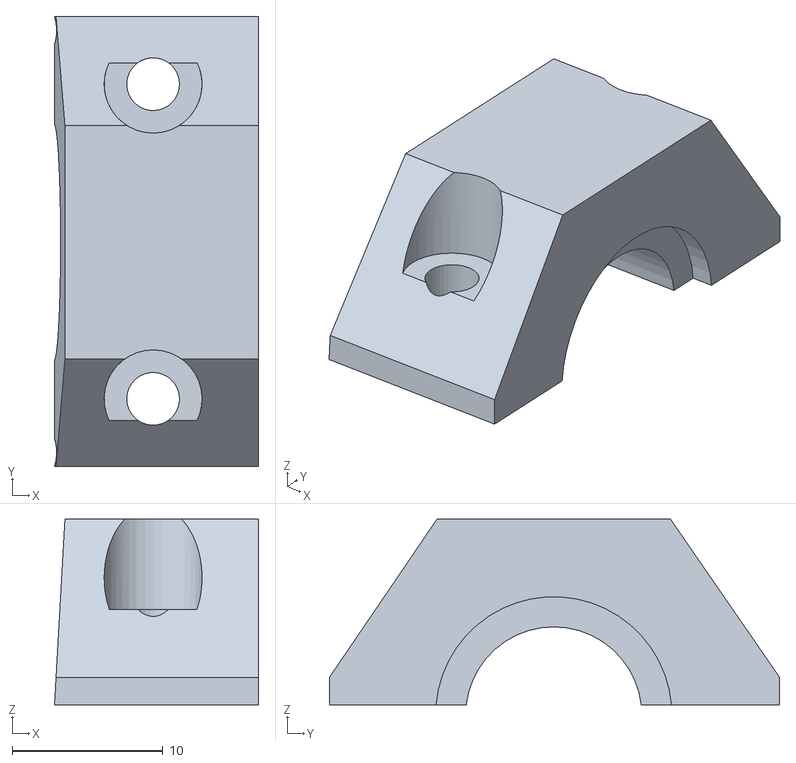
[picture p44: CAD file, 2021-09-24]
Baixe aqui os STLs/Eixo X/Presilha hotend V6.stl
13.6 x 29.9 x 12.3
