Prelo3D/graber-p3d/Baixe aqui os STLs/Eixo Z/Z topo esquerdo para guia 8mm.stl

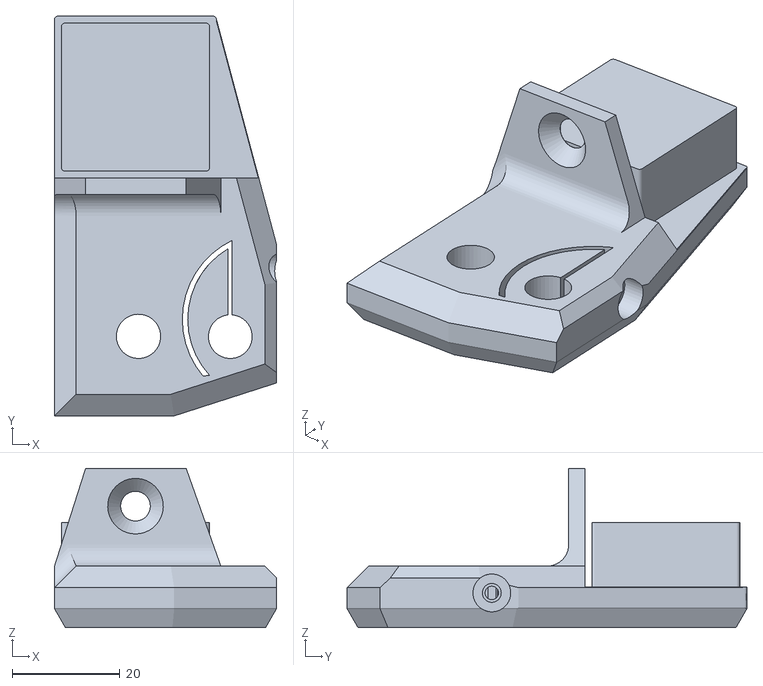
[picture p45: CAD file, 2021-09-24]
Baixe aqui os STLs/Eixo Z/Z topo esquerdo para guia 8mm.stl
41.1 x 74.0 x 29.5
