Prelo3D/graber-p3d/Baixe aqui os STLs/Eixo X/Carro X para rolamento 15mm.stl

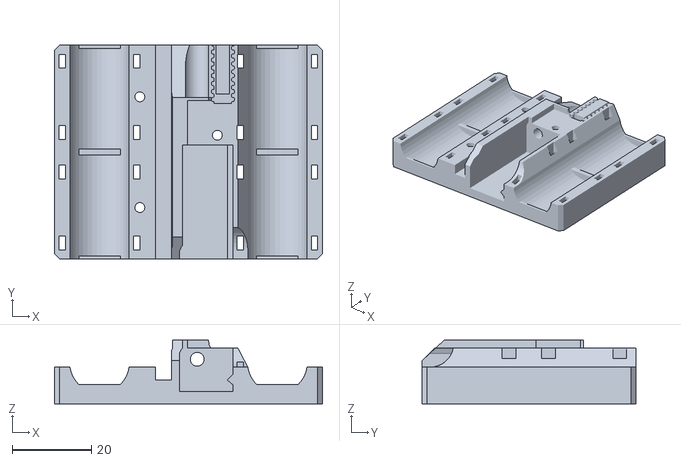
[picture p46: CAD file, 2021-09-24]
Baixe aqui os STLs/Eixo X/Carro X para rolamento 15mm.stl
67.8 x 54.1 x 16.1
