Prelo3D/graber-p3d/(list of files, cad)

Other CAD files:
Baixe aqui os STLs/Eixo Y/Suporte trazeiro direito guia 8mm mesa.stl
Baixe aqui os STLs/Eixo Y/Suporte trazeiro esquerdo guia 8mm mesa.stl
Baixe aqui os STLs/Pés de apoio/Trazeiro direito.stl
Baixe aqui os STLs/Eixo Y/Suporte frontal direito guia 8mm mesa.stl
Baixe aqui os STLs/Eixo Z/Suporte motor Z direito.stl
Baixe aqui os STLs/Pés de apoio/Frontal direito.stl
Baixe aqui os STLs/Eixo Z/Z topo direito para guia 8mm.stl
