Prelo3D/graber-p3d/(commit log)

2021-09-24 Update and rename Informações suporte guias mesa to Informações de preenchimento
2021-09-24 Create Informações de preenchimento
